BeyremHF/CPS-Plant-Health-Monitor/ESP32S3PlantMonitor/AnimationConnect.h

#ifndef ANIMATION_CONNECT_H
#define ANIMATION_CONNECT_H

// Animation: Connect_frames
// Size: 128x64, Frames: 17

#include <stdint.h>

static const uint8_t Connect_frames[17][1024] = {
  {0x00,0x00,0x00,0x00,0x00,0x00,0x00,0x00,0x00,0x00,0x00,0x00,0x00,0x00,0x00,0x00,0x00,0x00,0x00,0x00,0x00,0x00,0x00,0x00,0x00,0x00,0x00,0x00,0x00,0x00,0x00,0x00,0x00,0x00,0x00,0x00,0x00,0x00,0x00,0x00,0x00,0x00,0x00,0x00,0x00,0x00,0x00,0x00,0x00,0x00,0x00,0x00,0x00,0x00,0x00,0x00,0x00,0x00,0x00,0x00,0x00,0x00,0x00,0x00,0x00,0x00,0x00,0x00,0x00,0x00,0x00,0x00,0x00,0x00,0x00,0x00,0x00,0x00,0x00,0x00,0x00,0x00,0x00,0x00,0x00,0x00,0x00,0x00,0x00,0x00,0x00,0x00,0x00,0x00,0x00,0x00,0x00,0x00,0x00,0x00,0x00,0x00,0x00,0x00,0x00,0x00,0x00,0x00,0x00,0x00,0x00,0x00,0x00,0x00,0x00,0x00,0x00,0x00,0x00,0x00,0x00,0x00,0x00,0x00,0x00,0x00,0x00,0x00,0x00,0x00,0x00,0x00,0x38,0x00,0x00,0x00,0x40,0x00,0x00,0x00,0x00,0x00,0x00,0x00,0x00,0x00,0x00,0x00,0x44,0x00,0x00,0x00,0x40,0x02,0x40,0x00,0x00,0x00,0x00,0x00,0x00,0x00,0x00,0x00,0x02,0x4e,0xd3,0x38,0x4e,0x68,0x5c,0x00,0x00,0x00,0x00,0x00,0x00,0x00,0x00,0x00,0x02,0xd1,0x34,0x45,0x41,0x9a,0x62,0x00,0x00,0x00,0x00,0x00,0x00,0x00,0x00,0x00,0x02,0x51,0x14,0x7d,0xe1,0x8a,0x62,0x00,0x00,0x00,0x00,0x00,0x00,0x00,0x00,0x00,0x44,0x51,0x14,0x05,0x41,0x8a,0x62,0x00,0x00,0x00,0x00,0x00,0x00,0x00,0x00,0x00,0x38,0x4e,0x14,0x79,0x4e,0x8a,0x5c,0x00,0x00,0x00,0x00,0x00,0x00,0x00,0x00,0x00,0x00,0x00,0x00,0x00,0x00,0x00,0x40,0x00,0x00,0x00,0x00,0x00,0x00,0x00,0x00,0x00,0x00,0x00,0x00,0x00,0x00,0x00,0x42,0x00,0x00,0x00,0x00,0x00,0x00,0x00,0x00,0x00,0x00,0x00,0x00,0x00,0x00,0x00,0x3c,0x00,0x00,0x00,0x00,0x00,0x00,0x00,0x00,0x00,0x00,0x00,0x00,0x00,0x00,0x00,0x00,0x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
};


#endif // ANIMATION_CONNECT_H
