BeyremHF/CPS-Plant-Health-Monitor/ESP32S3PlantMonitor/Secrets.example.h

#ifndef SECRETS_H
#define SECRETS_H

// This file is a template. 
// Copy this file to Secrets.h in the same folder and put your own WiFi details in it. 

#define WIFI_SSID     "your-network-name"
#define WIFI_PASSWORD "your-network-password"

#endif
