BeyremHF/CPS-Plant-Health-Monitor/(commit log)

2026-08-23 add pump flag and better full report in serial monitor
2026-08-23 add soil moisture / pump triggering backup using board
2026-08-23 sync to one plant health indicator for the board OLED and frontend
2026-08-23 prefix ML labels with Random Forest so they aren't confused with board states
2026-08-23 ignore a pump trigger raised before the first soil reading
2026-08-23 put the temperature band on a source
2026-08-26 add float switch sensor
2026-09-03 README correction + renaming
    [AnimationConnect.h, AnimationHappy.h, AnimationModerate.h, AnimationSensing.h, AnimationStress.h, Config.h, Display.cpp, Display.h]
